ysp-021228/wheel-legged_robot/picture/1106d787874c910906931e404e03258.jpg

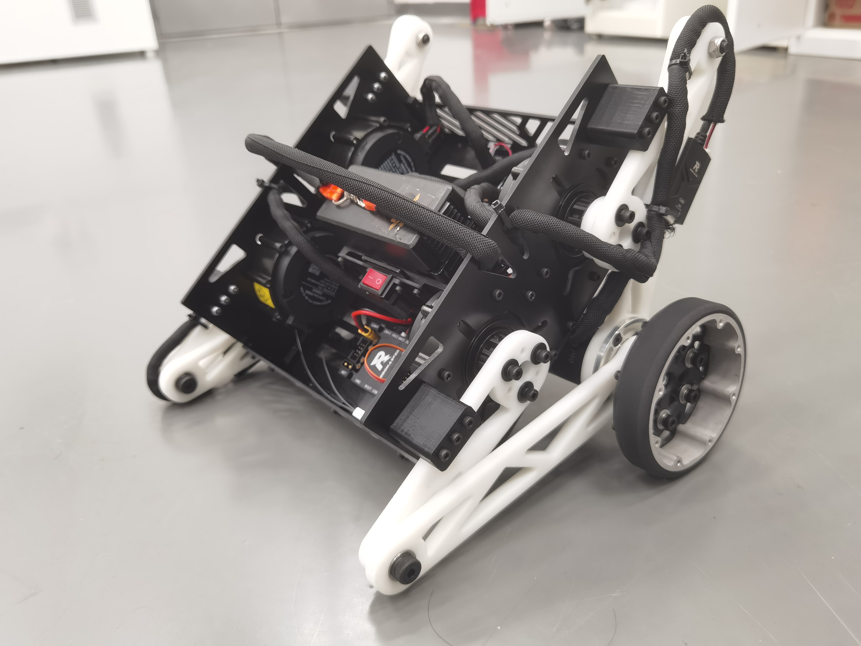
picture/1106d787874c910906931e404e03258.jpg
