ysp-021228/wheel-legged_robot/picture/f1f453ee73a97a37a0b2060098c7de4.jpg

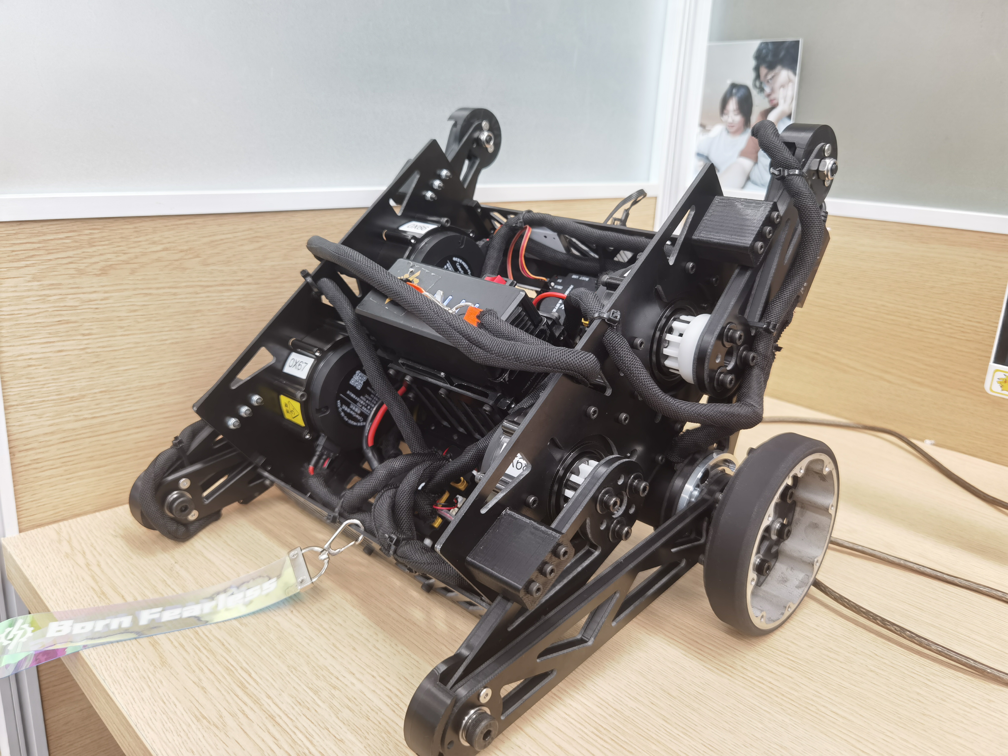
picture/f1f453ee73a97a37a0b2060098c7de4.jpg
