ysp-021228/wheel-legged_robot/picture/封面.png

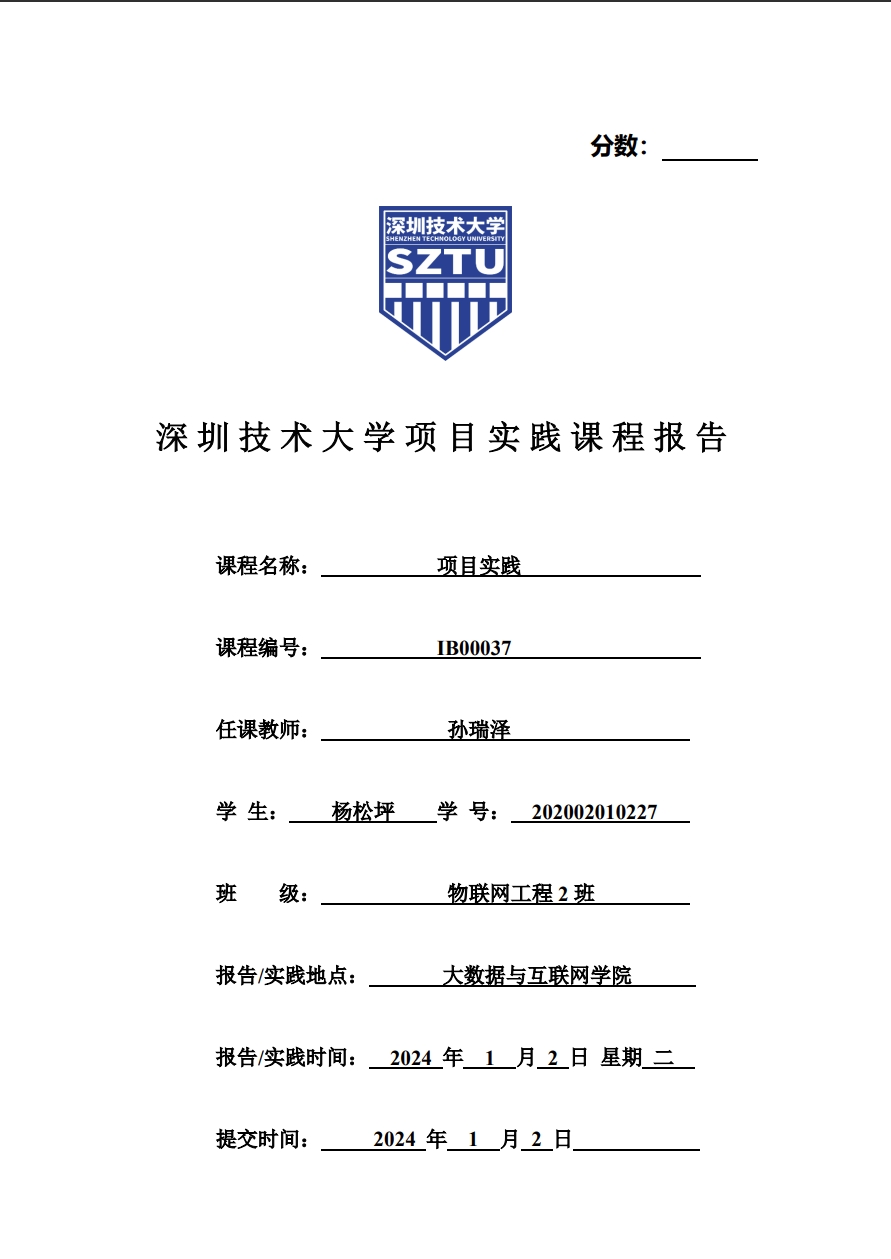
picture/封面.png
