ysp-021228/wheel-legged_robot/picture/支持力图片.jpg

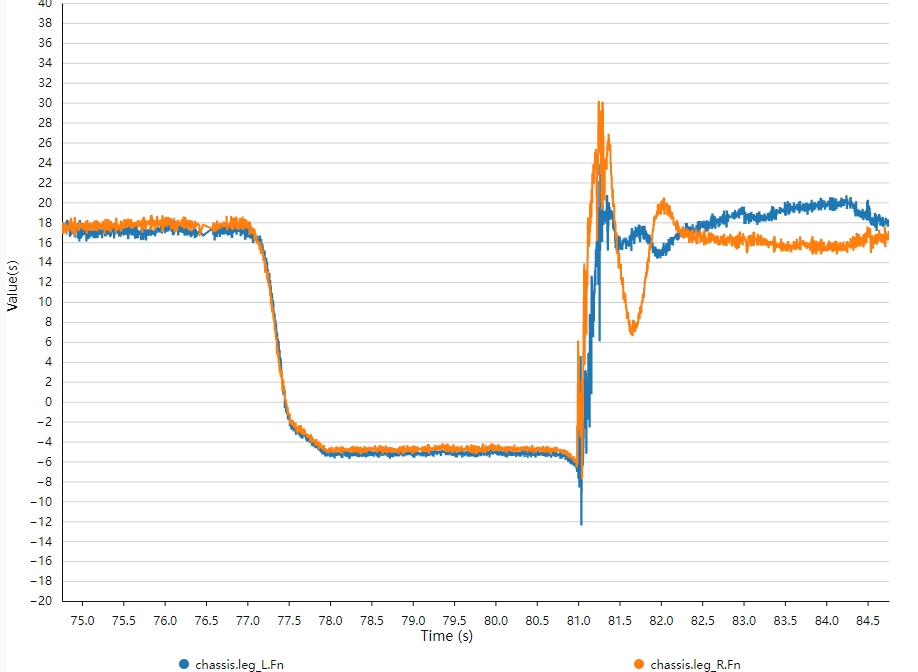
picture/支持力图片.jpg
