ysp-021228/wheel-legged_robot/picture/离地图片.jpg

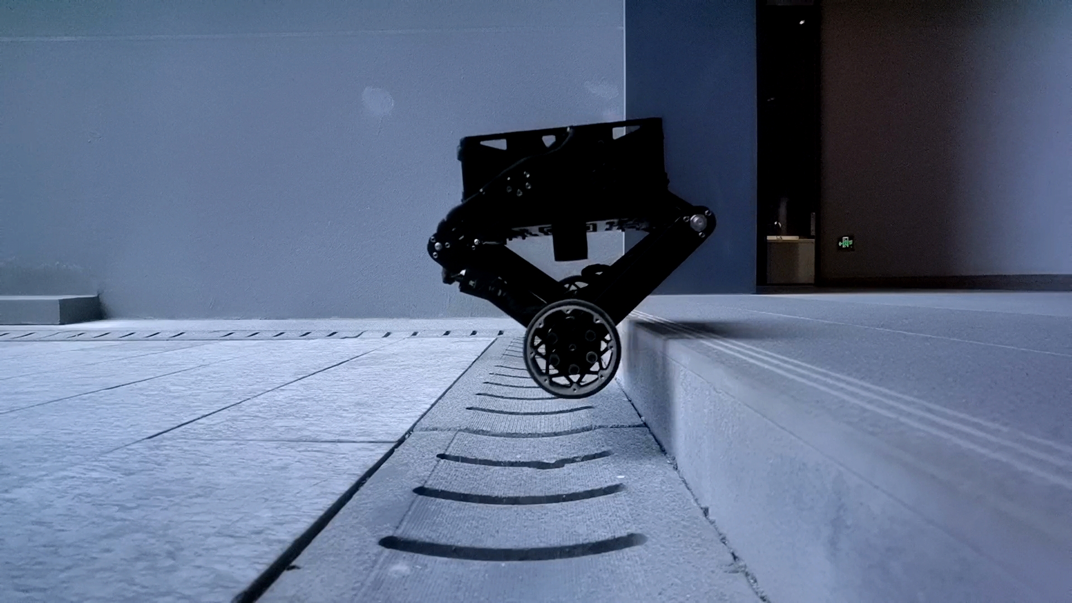
picture/离地图片.jpg
