ysp-021228/wheel-legged_robot/Core/Inc/main.h

#define BUTTON_TRIG_Pin GPIO_PIN_7
#define BUTTON_TRIG_GPIO_Port GPIOI
#define RSTN_IST8310_Pin GPIO_PIN_6
#define RSTN_IST8310_GPIO_Port GPIOG
#define LED_R_Pin GPIO_PIN_12
#define LED_R_GPIO_Port GPIOH
#define DRDY_IST8310_Pin GPIO_PIN_3
#define DRDY_IST8310_GPIO_Port GPIOG
#define DRDY_IST8310_EXTI_IRQn EXTI3_IRQn
#define ADC_BAT_Pin GPIO_PIN_10
#define ADC_BAT_GPIO_Port GPIOF
#define LED_G_Pin GPIO_PIN_11
#define LED_G_GPIO_Port GPIOH
#define LED_B_Pin GPIO_PIN_10
#define LED_B_GPIO_Port GPIOH
#define HW0_Pin GPIO_PIN_0
#define HW0_GPIO_Port GPIOC
#define HW1_Pin GPIO_PIN_1
#define HW1_GPIO_Port GPIOC
#define HW2_Pin GPIO_PIN_2
#define HW2_GPIO_Port GPIOC
#define BUZZER_Pin GPIO_PIN_14
#define BUZZER_GPIO_Port GPIOD
#define KEY_Pin GPIO_PIN_0
#define KEY_GPIO_Port GPIOA
#define CS1_ACCEL_Pin GPIO_PIN_4
#define CS1_ACCEL_GPIO_Port GPIOA
#define INT1_ACCEL_Pin GPIO_PIN_4
#define INT1_ACCEL_GPIO_Port GPIOC
#define INT1_ACCEL_EXTI_IRQn EXTI4_IRQn
#define INT1_GYRO_Pin GPIO_PIN_5
#define INT1_GYRO_GPIO_Port GPIOC
#define INT1_GYRO_EXTI_IRQn EXTI9_5_IRQn
#define SPI2_CS_Pin GPIO_PIN_12
#define SPI2_CS_GPIO_Port GPIOB
#define CS1_GYRO_Pin GPIO_PIN_0
#define CS1_GYRO_GPIO_Port GPIOB
