ysp-021228/wheel-legged_robot/App/Src/Bot/Device/CyberGear.c

#include "Device/CyberGear.h"
#include "can.h"

/*
 * 小米电机使用说明
 * 1.需要在CAN中断回调函数调用mi_motor_data_get()函数，以确保数据接收
 * 2.在使用前使用mi_motor_init()函数实现电机初始化 须填入CAN总线句柄和电机id及对应的结构体数组
 * 3.使用mi_motor_mode()函数设置电机模式 0:运控模式 1:位置模式 2:速度模式 3:电流模式（默认为运控模式）
 * 4.使用mi_motor_enable()函数使能电机
 * 5.使用mi_motor_disable()函数失能电机
 * 6.使用mi_motor_control_mode()函数设置电机运控模式（运控模式）
 * 7.使用mi_motor_write()函数设置电机参数（位置模式，速度模式，电流模式）
 * 8.使用mi_motor_read()函数读取电机设置参数
 */

/**
 * @brief 小米电机CAN1数据数组
 */
struct CyberGearData cybergears_1[MI_MOTOR_SINGLE_NUM];

/**
 * @brief 小米电机CAN2数据数组
 */
struct CyberGearData cybergears_2[MI_MOTOR_SINGLE_NUM];

/**
 * @brief 小米电机CAN 扩展帧ID信息联合体
 */
union {
  uint32_t ExtId;
  struct {
    uint32_t id: 8;
    uint32_t data: 16;
    uint32_t mode: 5;
    uint32_t res: 3;
  };
} exCanIdInfo;

static int float_to_uint(float x, float x_min, float x_max);

static float uint_to_float(int x_int, float x_min, float x_max);

static void mi_motor_can_send(struct CyberGearData *mi_motor_data);

/**
 * @brief 小米电机CAN数据转换函数
 * @param x
 * @param x_min
 * @param x_max
 * @return
 */
static int float_to_uint(float x, float x_min, float x_max) {
  float span = x_max - x_min;
  float offset = x_min;
  if (x > x_max) x = x_max;
  else if (x < x_min) x = x_min;
  return (int) ((x - offset) * ((float) ((1 << 16) - 1)) / span);
}

/**
 * @brief 小米电机CAN数据转换函数
 * @param x_int
 * @param x_min
 * @param x_max
 * @return
 */
static float uint_to_float(int x_int, float x_min, float x_max) {
  //converts unsigned int to float, given range
  float span = x_max - x_min;
  float offset = x_min;
  return ((float) x_int) * span / ((float) ((1 << 16) - 1)) + offset;
}

/**
 * @brief 小米电机CAN发送函数
 * @param mi_motor_data 电机数据结构体
 */
static void mi_motor_can_send(struct CyberGearData *mi_motor_data) {
  CAN_TxHeaderTypeDef tx_header;
  uint8_t tx_data[8];
  uint32_t send_mail_box;
//  send_mail_box=get_free_can_mailbox();

  exCanIdInfo.mode = mi_motor_data->mode;
  exCanIdInfo.id = mi_motor_data->id;
  exCanIdInfo.data = mi_motor_data->data;
  exCanIdInfo.res = 0;

  tx_header.ExtId = exCanIdInfo.ExtId;
  tx_header.IDE = CAN_ID_EXT;
  tx_header.RTR = CAN_RTR_DATA;
  tx_header.DLC = 8;

  memcpy(tx_data, mi_motor_data->tx_data, 8);

  HAL_CAN_AddTxMessage(&mi_motor_data->canHandleTypeDef, &tx_header, tx_data, &send_mail_box);
}

/**
 * @brief 小米电机ID读取函数
 * @param mi_motor_data 电机数据结构体
 */
void mi_motor_id_get(struct CyberGearData *mi_motor_data) {
  mi_motor_data->mode = 0;
  union {
    uint16_t ex_data;
    struct {
      uint16_t master_id: 8;
      uint16_t res: 8;
    };
  } ex_data;
  ex_data.master_id = MI_MOTOR_MASTER_ID;
  ex_data.res = 0;
  mi_motor_data->data = ex_data.ex_data;
  memset(&mi_motor_data->tx_data, 0, 8);
  mi_motor_can_send(mi_motor_data);
}

/**
 * @brief 电机运控模式函数
 * @param mi_motor_data 电机数据结构体
 * @param torque 力矩指令 -12~12N.m
 * @param MechPosition 电机磁编码器角度指令 -12.5~12.5rad
 * @param speed 电机速度指令 -30~30rad/s
 * @param kp 位置环kp
 * @param kd 速度环kd
 */
void cyber_gear_control_mode(struct CyberGearData *mi_motor_data, float torque, float MechPosition, float speed, float kp,
                             float kd) {
  mi_motor_data->mode = 1;
  mi_motor_data->data = float_to_uint(torque, MI_MOTOR_T_MIN, MI_MOTOR_T_MAX);

  mi_motor_data->tx_data[0] = float_to_uint(MechPosition, MI_MOTOR_P_MIN, MI_MOTOR_P_MAX) >> 8;
  mi_motor_data->tx_data[1] = float_to_uint(MechPosition, MI_MOTOR_P_MIN, MI_MOTOR_P_MAX);
  mi_motor_data->tx_data[2] = float_to_uint(speed, MI_MOTOR_V_MIN, MI_MOTOR_V_MAX) >> 8;
  mi_motor_data->tx_data[3] = float_to_uint(speed, MI_MOTOR_V_MIN, MI_MOTOR_V_MAX);
  mi_motor_data->tx_data[4] = float_to_uint(kp, MI_MOTOR_KP_MIN, MI_MOTOR_KP_MAX) >> 8;
  mi_motor_data->tx_data[5] = float_to_uint(kp, MI_MOTOR_KP_MIN, MI_MOTOR_KP_MAX);
  mi_motor_data->tx_data[6] = float_to_uint(kd, MI_MOTOR_KD_MIN, MI_MOTOR_KD_MAX) >> 8;
  mi_motor_data->tx_data[7] = float_to_uint(kd, MI_MOTOR_KD_MIN, MI_MOTOR_KD_MAX);
  mi_motor_can_send(mi_motor_data);
}

/**
 * @brief 小米电机初始化函数（在电机使用前必须调用）
 * @param canHandleTypeDef 电机CAN总线选择 hcan1/hcan2
 * @param id 电机id
 * @param mi_motor_data 电机数据结构体
 */
void cyber_gear_init(CAN_HandleTypeDef canHandleTypeDef, uint8_t id, struct CyberGearData *mi_motor_data) {
  union {
    uint16_t ex_data;
    struct {
      uint16_t master_id: 8;
      uint16_t res: 8;
    };
  } ex_data;
  ex_data.master_id = MI_MOTOR_MASTER_ID;
  ex_data.res = 0;
  mi_motor_data->data = ex_data.ex_data;
  mi_motor_data->id = id;
  mi_motor_data->canHandleTypeDef = canHandleTypeDef;
  memset(&mi_motor_data->tx_data, 0, 8);
}

/**
 * @brief 小米电机使能函数
 * @param mi_motor_data 电机数据结构体
 */
void cyber_gear_enable(struct CyberGearData *mi_motor_data) {
  mi_motor_data->mode = 3;
  union {
    uint16_t ex_data;
    struct {
      uint16_t master_id: 8;
      uint16_t res: 8;
    };
  } ex_data;
  ex_data.master_id = MI_MOTOR_MASTER_ID;
  ex_data.res = 0;
  mi_motor_data->data = ex_data.ex_data;
  memset(&mi_motor_data->tx_data, 0, 8);
  mi_motor_can_send(mi_motor_data);
}

/**
 * @brief 小米电机失能函数
 * @param mi_motor_data 电机数据结构体
 */
void mi_motor_disable(struct CyberGearData *mi_motor_data) {
  mi_motor_data->mode = 4;
  union {
    uint16_t ex_data;
    struct {
      uint16_t master_id: 8;
      uint16_t res: 8;
    };
  } ex_data;
  ex_data.master_id = MI_MOTOR_MASTER_ID;
  ex_data.res = 0;
  mi_motor_data->data = ex_data.ex_data;
  memset(&mi_motor_data->tx_data, 0, 8);
  mi_motor_can_send(mi_motor_data);
}

/**
 * @brief 小米电机清除错误函数
 * @param mi_motor_data 电机数据结构体
 */
void mi_motor_clear_err(struct CyberGearData *mi_motor_data) {
  mi_motor_data->mode = 4;
  union {
    uint16_t ex_data;
    struct {
      uint16_t master_id: 8;
      uint16_t res: 8;
    };
  } ex_data;
  ex_data.master_id = MI_MOTOR_MASTER_ID;
  ex_data.res = 0;
  mi_motor_data->data = ex_data.ex_data;
  memset(&mi_motor_data->tx_data, 0, 8);
  mi_motor_data->tx_data[0] = 1;
  mi_motor_can_send(mi_motor_data);
}

/**
 * @brief 小米电机设置零点函数
 * @param mi_motor_data 电机数据结构体
 */
void mi_motor_set_zero(struct CyberGearData *mi_motor_data) {
  mi_motor_data->mode = 6;
  union {
    uint16_t ex_data;
    struct {
      uint16_t master_id: 8;
      uint16_t res: 8;
    };
  } ex_data;
  ex_data.master_id = MI_MOTOR_MASTER_ID;
  ex_data.res = 0;
  mi_motor_data->data = ex_data.ex_data;
  memset(&mi_motor_data->tx_data, 0, 8);
  mi_motor_data->tx_data[0] = 1;
  mi_motor_can_send(mi_motor_data);
}

/**
 * @brief 小米电机设置id函数
 * @param mi_motor_data 电机数据结构体
 * @param set_id 设置新的id值
 */
void mi_motor_set_id(struct CyberGearData *mi_motor_data, uint8_t set_id) {
  mi_motor_data->mode = 7;
  union {
    uint16_t ex_data;
    struct {
      uint16_t master_id: 8;
      uint16_t set_id: 8;
    };
  } ex_data;
  ex_data.master_id = MI_MOTOR_MASTER_ID;
  ex_data.set_id = set_id;
  mi_motor_data->data = ex_data.ex_data;
  memset(&mi_motor_data->tx_data, 0, 8);
  mi_motor_can_send(mi_motor_data);
}

/**
 * @brief 小米电机数据读取函数
 * @param mi_motor_data 电机数据结构体
 * @param index 参数
 */
void mi_motor_read(struct CyberGearData *mi_motor_data, uint16_t index) {
  mi_motor_data->mode = 17;
  union {
    uint16_t ex_data;
    struct {
      uint16_t master_id: 8;
      uint16_t res: 8;
    };
  } ex_data;
  ex_data.master_id = MI_MOTOR_MASTER_ID;
  ex_data.res = 0;
  mi_motor_data->data = ex_data.ex_data;
  memset(&mi_motor_data->tx_data, 0, 8);
  memcpy(&mi_motor_data->tx_data[0], &index, 2);
  mi_motor_can_send(mi_motor_data);
}

/**
 * @brief 小米电机模式设置函数
 * @param mi_motor_data 电机数据结构体
 * @param mode 模式 0:运控模式 1:位置模式 2:速度模式 3:电流模式
 */
void cyber_gear_mode(struct CyberGearData *mi_motor_data, uint8_t mode) {
  uint16_t index = MI_MOTOR_RUN_MODE_INDEX;
  mi_motor_data->mode = 18;
  union {
    uint16_t ex_data;
    struct {
      uint16_t master_id: 8;
      uint16_t res: 8;
    };
  } ex_data;
  ex_data.master_id = MI_MOTOR_MASTER_ID;
  ex_data.res = 0;
  mi_motor_data->data = ex_data.ex_data;
  memset(&mi_motor_data->tx_data, 0, 8);
  memcpy(&mi_motor_data->tx_data[0], &index, 2);
  memcpy(&mi_motor_data->tx_data[4], &mode, 1);
  mi_motor_can_send(mi_motor_data);
}

/**
 * @brief 小米电机数据写入函数
 * @param mi_motor_data 电机数据结构体
 * @param index 参数
 * @param ref   参数值
 */
void mi_motor_write(struct CyberGearData *mi_motor_data, uint16_t index, float ref) {
  mi_motor_data->mode = 18;
  union {
    uint16_t ex_data;
    struct {
      uint16_t master_id: 8;
      uint16_t res: 8;
    };
  } ex_data;
  ex_data.master_id = MI_MOTOR_MASTER_ID;
  ex_data.res = 0;
  mi_motor_data->data = ex_data.ex_data;
  memset(&mi_motor_data->tx_data, 0, 8);
  memcpy(&mi_motor_data->tx_data[0], &index, 2);
  memcpy(&mi_motor_data->tx_data[4], &ref, 4);
  mi_motor_can_send(mi_motor_data);
}

/**
 * @brief 小米电机CAN数据读取函数（需要在CAN中断回调中调用）
 * @param hcan
 * @param rx_header
 * @param rx_data
 */
void mi_motor_data_get(CAN_HandleTypeDef *hcan, CAN_RxHeaderTypeDef rx_header, const uint8_t rx_data[8]) {
  exCanIdInfo.ExtId = rx_header.ExtId;
  union {
    uint16_t ex_data;
    struct {
      uint16_t motor_id: 8;
      uint16_t res: 8;
    };
  } ex_data;
  ex_data.ex_data = exCanIdInfo.data;
  if (hcan == &hcan1) {
    if (exCanIdInfo.mode == 2) {
      cybergears_1[ex_data.motor_id].id = ex_data.motor_id;
      cybergears_1[ex_data.motor_id].mode = exCanIdInfo.mode;
      cybergears_1[ex_data.motor_id].data = exCanIdInfo.data;

      uint16_t raw_angle = (int16_t) ((rx_data[0] << 8) | rx_data[1]);
      uint16_t raw_speed = (int16_t) ((rx_data[2] << 8) | rx_data[3]);
      uint16_t raw_torque = (int16_t) ((rx_data[4] << 8) | rx_data[5]);
      uint16_t raw_temp = (int16_t) ((rx_data[6] << 8) | rx_data[7]);

      cybergears_1[ex_data.motor_id].angle = uint_to_float(raw_angle, MI_MOTOR_P_MIN, MI_MOTOR_P_MAX);
      cybergears_1[ex_data.motor_id].speed = uint_to_float(raw_speed, MI_MOTOR_V_MIN, MI_MOTOR_V_MAX);
      cybergears_1[ex_data.motor_id].torque = uint_to_float(raw_torque, MI_MOTOR_T_MIN, MI_MOTOR_T_MAX);
      cybergears_1[ex_data.motor_id].temp = (float) raw_temp / 10.0f;

    } else if (exCanIdInfo.mode == 17) {
      memcpy(cybergears_1[ex_data.motor_id].index, rx_data, 2);
      memcpy(cybergears_1[ex_data.motor_id].ref, &rx_data[4], 4);
    } else if (exCanIdInfo.mode == 21) {
      memcpy(cybergears_1[ex_data.motor_id].fault, rx_data, 4);
      memcpy(cybergears_1[ex_data.motor_id].warning, &rx_data[4], 4);
    }
  } else if (hcan == &hcan2) {
    if (exCanIdInfo.mode == 2) {
      cybergears_2[ex_data.motor_id].id = ex_data.motor_id;
      cybergears_2[ex_data.motor_id].mode = exCanIdInfo.mode;
      cybergears_2[ex_data.motor_id].data = exCanIdInfo.data;

      uint16_t raw_angle = (int16_t) ((rx_data[0] << 8) | rx_data[1]);
      uint16_t raw_speed = (int16_t) ((rx_data[2] << 8) | rx_data[3]);
      uint16_t raw_torque = (int16_t) ((rx_data[4] << 8) | rx_data[5]);
      uint16_t raw_temp = (int16_t) ((rx_data[6] << 8) | rx_data[7]);

      cybergears_2[ex_data.motor_id].angle = uint_to_float(raw_angle, MI_MOTOR_P_MIN, MI_MOTOR_P_MAX);
      cybergears_2[ex_data.motor_id].speed = uint_to_float(raw_speed, MI_MOTOR_V_MIN, MI_MOTOR_V_MAX);
      cybergears_2[ex_data.motor_id].torque = uint_to_float(raw_torque, MI_MOTOR_T_MIN, MI_MOTOR_T_MAX);
      cybergears_2[ex_data.motor_id].temp = (float) raw_temp / 10.0f;

    } else if (exCanIdInfo.mode == 17) {
      memcpy(cybergears_2[ex_data.motor_id].index, rx_data, 2);
      memcpy(cybergears_2[ex_data.motor_id].ref, &rx_data[4], 4);
    } else if (exCanIdInfo.mode == 21) {
      memcpy(cybergears_2[ex_data.motor_id].fault, rx_data, 4);
      memcpy(cybergears_2[ex_data.motor_id].warning, &rx_data[4], 4);
    }
  }
}
