ysp-021228/wheel-legged_robot/App/Inc/Bot/Device/key_board.h

//
// Created by xhuanc on 2021/12/3.
//

#ifndef DEMO1_KEY_BOARD_H
#define DEMO1_KEY_BOARD_H
#include "IO/remote.h"

#define DEFAULT_CNT 100/24 // 100/任务周期=实际经过时间
#define MOUSE_CLICK_R_CNT 5
#define MOUSE_CLICK_L_CNT 20
#define MOUSE_X_RADIO 0.015f
#define MOUSE_Y_RADIO 0.01f

typedef enum{
    KEY_RELAX,//按键没被按下
    KEY_DOWN,
    KEY_CLICK,//PRESS 一下之后就RELAX 就是CLICK
    KEY_PRESS,//PRESS 超过一段时间 DOWN
}Key_Status;

typedef struct {
    Key_Status status;
    Key_Status last_status;
    uint32_t press_cnt;
    uint8_t click_flag;
    uint32_t click_cnt;
}Key;

//键盘结构体
typedef struct {
    Key Mouse_l;
    Key Mouse_r;
    Key W;
    Key S;
    Key A;
    Key D;
    Key Q;
    Key E;
    Key R;
    Key F;
    Key G;
    Key Z;
    Key X;
    Key C;
    Key B;
    Key V;
    Key SHIFT;
    Key CTRL;
}key_board_t;
extern void update_pc_info();

#endif //DEMO1_KEY_BOARD_H
