ysp-021228/wheel-legged_robot/bsp/bsp_usart.h

#ifndef BSP_USART_H
#define BSP_USART_H
#include "struct_typedef.h"

extern void usart1_init(uint8_t *rx_buf,uint16_t dma_buf_num);
extern void usart6_init(uint8_t *rx1_buf,uint16_t dma_buf_num);
extern void uart6_tx_one_byte(uint8_t* data);
extern void uart6_tx_mul_byte_dma(uint8_t* data,uint16_t len);
extern void usart6_tx_dma_enable(uint8_t* data,uint16_t len);
extern void usart1_tx_dma_init(void);
extern void usart1_tx_dma_enable(uint8_t *data, uint16_t len);
#endif
