ysp-021228/wheel-legged_robot/App/Src/Bot/Device/Calibrate.c

/**
  ****************************(C) COPYRIGHT 2019 DJI****************************
  * @file       calibrate_task.c/h
  * @brief      calibrate these device，include gimbal, gyro, accel, magnetometer,
  *             chassis. gimbal calibration is to calc the midpoint, max/min
  *             relative angle. gyro calibration is to calc the zero drift.
  *             accel and mag calibration have not been implemented yet, because
  *             accel is not necessary to calibrate, mag is not used. chassis
  *             calibration is to make motor 3508 enter quick reset ID mode.
  *             校准设备，包括云台,陀螺仪,加速度计,磁力计,底盘.云台校准是主要计算零点
  *             和最大最小相对角度.云台校准是主要计算零漂.加速度计和磁力计校准还没有实现
  *             因为加速度计还没有必要去校准,而磁力计还没有用.底盘校准是使M3508进入快速
  *             设置ID模式.
  * @note
  * @history
  *  Version    Date            Author          Modification
  *  V1.0.0     Oct-25-2018     RM              1. done
  *  V1.1.0     Nov-11-2019     RM              1. add chassis clabration
  *
  @verbatim
  ==============================================================================
  *             use the remote control begin calibrate,
  *             first: two switchs of remote control are down
  *             second:hold for 2 seconds, two rockers set to V, like \../;  \. means the letf rocker go bottom right.
  *             third:hold for 2 seconds, two rockers set to ./\., begin the gyro calibration
  *                     or set to '\/', begin the gimbal calibration
  *                     or set to /''\, begin the chassis calibration
  *
  *             data in flash, include cali data and name[3] and cali_flag
  *             for example, head_cali has 8 bytes, and it need 12 bytes in flash. if it starts in 0x080A0000
  *             0x080A0000-0x080A0007: head_cali data
  *             0x080A0008: name[0]
  *             0x080A0009: name[1]
  *             0x080A000A: name[2]
  *             0x080A000B: cali_flag, when cali_flag == 0x55, means head_cali has been calibrated.
  *             if add a sensor
  *             1.add cail sensro name in cali_id_e at calibrate_task.h, like
  *             typedef enum
  *             {
  *                 ...
  *                 //add more...
  *                 CALI_XXX,
  *                 CALI_LIST_LENGHT,
  *             } cali_id_e;
  *             2. add the new data struct in calibrate_task.h, must be 4 four-byte mulitple  like
  *
  *             typedef struct
  *             {
  *                 uint16_t xxx;
  *                 uint16_t yyy;
  *                 fp32 zzz;
  *             } xxx_cali_t; //size: 8 bytes, must be 4, 8, 12, 16...
  *             3.in "FLASH_WRITE_BUF_LENGHT", add "sizeof(xxx_cali_t)", and implement new function.
  *             bool_t cali_xxx_hook(uint32_t *cali, bool_t cmd), and add the name in "cali_name[CALI_LIST_LENGHT][3]"
  *             and declare variable xxx_cali_t xxx_cail, add the data address in cali_sensor_buf[CALI_LIST_LENGHT]
  *             and add the data lenght in cali_sensor_size, at last, add function in cali_hook_fun[CALI_LIST_LENGHT]
  *             使用遥控器进行开始校准
  *             第一步:遥控器的两个开关都打到下
  *             第二步:两个摇杆打成\../,保存两秒.\.代表左摇杆向右下打.
  *             第三步:摇杆打成./\. 开始陀螺仪校准
  *                    或者摇杆打成'\/' 开始云台校准021228
  *                    或者摇杆打成/''\ 开始底盘校准
  *
  *             数据在flash中，包括校准数据和名字 name[3] 和 校准标志位 cali_flag
  *             例如head_cali有八个字节,但它需要12字节在flash,如果它从0x080A0000开始
  *             0x080A0000-0x080A0007: head_cali数据
  *             0x080A0008: 名字name[0]
  *             0x080A0009: 名字name[1]
  *             0x080A000A: 名字name[2]
  *             0x080A000B: 校准标志位 cali_flag,当校准标志位为0x55,意味着head_cali已经校准了
  *             添加新设备
  *             1.添加设备名在calibrate_task.h的cali_id_e, 像
  *             typedef enum
  *             {
  *                 ...
  *                 //add more...
  *                 CALI_XXX,
  *                 CALI_LIST_LENGHT,
  *             } cali_id_e;
  *             2. 添加数据结构在 calibrate_task.h, 必须4字节倍数，像
  *
  *             typedef struct
  *             {
  *                 uint16_t xxx;
  *                 uint16_t yyy;
  *                 fp32 zzz;
  *             } xxx_cali_t; //长度:8字节 8 bytes, 必须是 4, 8, 12, 16...
  *             3.在 "FLASH_WRITE_BUF_LENGHT",添加"sizeof(xxx_cali_t)", 和实现新函数
  *             bool_t cali_xxx_hook(uint32_t *cali, bool_t cmd), 添加新名字在 "cali_name[CALI_LIST_LENGHT][3]"
  *             和申明变量 xxx_cali_t xxx_cail, 添加变量地址在cali_sensor_buf[CALI_LIST_LENGHT]
  *             在cali_sensor_size[CALI_LIST_LENGHT]添加数据长度, 最后在cali_hook_fun[CALI_LIST_LENGHT]添加函数
  *
  ==============================================================================
  @endverbatim
  ****************************(C) COPYRIGHT 2019 DJI****************************
  */

#include "Device/Calibrate.h"
#include "string.h"
#include "cmsis_os.h"

#include "bsp_adc.h"
#include "bsp_buzzer.h"
#include "bsp_flash.h"

#include "IO/can_receive.h"
#include "IO/remote.h"
#include "Atti.h"
#include "Subsystem/Gimbal.h"


//include head,gimbal,gyro,accel,mag. gyro,accel and mag have the same data struct. total 5(CALI_LIST_LENGHT) devices, need data lenght + 5 * 4 bytes(name[3]+cali)
#define FLASH_WRITE_BUF_LENGHT  (sizeof(head_cali_t) + sizeof(gimbal_cali_t) + sizeof(imu_cali_t) * 3  + CALI_LIST_LENGHT * 4)




/**
  * @brief          use remote control to begin a calibrate,such as gyro, gimbal, chassis
  * @param[in]      none
  * @retval         none
  */
/**
  * @brief          使用遥控器开始校准，例如陀螺仪，云台，底盘
  * @param[in]      none
  * @retval         none
  */
static void RC_cmd_to_calibrate(void);

/**
  * @brief          read cali data from flash
  * @param[in]      none
  * @retval         none
  */
/**
  * @brief          从flash读取校准数据
  * @param[in]      none
  * @retval         none
  */
static void cali_data_read(void);

/**
  * @brief          write the data to flash
  * @param[in]      none
  * @retval         none
  */
/**
  * @brief          往flash写入校准数据
  * @param[in]      none
  * @retval         none
  */
static void cali_data_write(void);


/**
  * @brief          "head" sensor cali function
  * @param[in][out] cali:the point to head data. when cmd == CALI_FUNC_CMD_INIT, param is [in],cmd == CALI_FUNC_CMD_ON, param is [out]
  * @param[in]      cmd:
                    CALI_FUNC_CMD_INIT: means to use cali data to initialize original data
                    CALI_FUNC_CMD_ON: means need to calibrate
  * @retval         0:means cali task has not been done
                    1:means cali task has been done
  */
/**
  * @brief          "head"设备校准
  * @param[in][out] cali:指针指向head数据,当cmd为CALI_FUNC_CMD_INIT, 参数是输入,CALI_FUNC_CMD_ON,参数是输出
  * @param[in]      cmd:
                    CALI_FUNC_CMD_INIT: 代表用校准数据初始化原始数据
                    CALI_FUNC_CMD_ON: 代表需要校准
  * @retval         0:校准任务还没有完
                    1:校准任务已经完成
  */
static bool_t cali_head_hook(uint32_t *cali, bool_t cmd);   //header device cali function

/**
  * @brief          gyro cali function
  * @param[in][out] cali:the point to gyro data, when cmd == CALI_FUNC_CMD_INIT, param is [in],cmd == CALI_FUNC_CMD_ON, param is [out]
  * @param[in]      cmd:
                    CALI_FUNC_CMD_INIT: means to use cali data to initialize original data
                    CALI_FUNC_CMD_ON: means need to calibrate
  * @retval         0:means cali task has not been done
                    1:means cali task has been done
  */
/**
  * @brief          陀螺仪设备校准
  * @param[in][out] cali:指针指向陀螺仪数据,当cmd为CALI_FUNC_CMD_INIT, 参数是输入,CALI_FUNC_CMD_ON,参数是输出
  * @param[in]      cmd:
                    CALI_FUNC_CMD_INIT: 代表用校准数据初始化原始数据
                    CALI_FUNC_CMD_ON: 代表需要校准
  * @retval         0:校准任务还没有完
                    1:校准任务已经完成
  */
static bool_t cali_gyro_hook(uint32_t *cali, bool_t cmd);   //gyro device cali function

/**
  * @brief          gimbal cali function
  * @param[in][out] cali:the point to gimbal data, when cmd == CALI_FUNC_CMD_INIT, param is [in],cmd == CALI_FUNC_CMD_ON, param is [out]
  * @param[in]      cmd:
                    CALI_FUNC_CMD_INIT: means to use cali data to initialize original data
                    CALI_FUNC_CMD_ON: means need to calibrate
  * @retval         0:means cali task has not been done
                    1:means cali task has been done
  */
/**
  * @brief          云台设备校准
  * @param[in][out] cali:指针指向云台数据,当cmd为CALI_FUNC_CMD_INIT, 参数是输入,CALI_FUNC_CMD_ON,参数是输出
  * @param[in]      cmd:
                    CALI_FUNC_CMD_INIT: 代表用校准数据初始化原始数据
                    CALI_FUNC_CMD_ON: 代表需要校准
  * @retval         0:校准任务还没有完
                    1:校准任务已经完成
  */
static bool_t cali_gimbal_hook(uint32_t *cali, bool_t cmd); //gimbal device cali function



#if INCLUDE_uxTaskGetStackHighWaterMark
uint32_t calibrate_task_stack;
#endif

extern struct RCCtrl rc_ctrl;
static const struct RCCtrl *calibrate_RC;   //remote control point
head_cali_t     head_cali;       //head cali data
gimbal_cali_t   gimbal_cali;     //gimbal cali data
imu_cali_t      accel_cali;      //accel cali data
imu_cali_t      gyro_cali;       //gyro cali data
imu_cali_t      mag_cali;        //mag cali data


static uint8_t flash_write_buf[FLASH_WRITE_BUF_LENGHT];

cali_sensor_t cali_sensor[CALI_LIST_LENGHT];

static const uint8_t cali_name[CALI_LIST_LENGHT][3] = {"HD", "GM", "GYR", "ACC", "MAG"};

//cali data address
static uint32_t *cali_sensor_buf[CALI_LIST_LENGHT] = {
        (uint32_t *)&head_cali, (uint32_t *)&gimbal_cali,
        (uint32_t *)&gyro_cali, (uint32_t *)&accel_cali,
        (uint32_t *)&mag_cali
};


static uint8_t cali_sensor_size[CALI_LIST_LENGHT] =
        {
                sizeof(head_cali_t) / 4, sizeof(gimbal_cali_t) / 4,
                sizeof(imu_cali_t) / 4, sizeof(imu_cali_t) / 4, sizeof(imu_cali_t) / 4};

void *cali_hook_fun[CALI_LIST_LENGHT] = {cali_head_hook, cali_gimbal_hook, cali_gyro_hook, NULL, NULL};

static uint32_t calibrate_systemTick;


/**
  * @brief          calibrate task, created by main function
  * @param[in]      pvParameters: null
  * @retval         none
  */
/**
  * @brief          校准任务，由main函数创建
  * @param[in]      pvParameters: 空
  * @retval         none
  */
void calibrate_task(void const *pvParameters)
{
    static uint8_t i = 0;

    calibrate_RC = &rc_ctrl;

    while (1)
    {

        RC_cmd_to_calibrate();

        for (i = 0; i < CALI_LIST_LENGHT; i++)
        {
            if (cali_sensor[i].cali_cmd)
            {
                if (cali_sensor[i].cali_hook != NULL)
                {

                    if (cali_sensor[i].cali_hook(cali_sensor_buf[i], CALI_FUNC_CMD_ON))
                    {
                        //done
                        cali_sensor[i].name[0] = cali_name[i][0];
                        cali_sensor[i].name[1] = cali_name[i][1];
                        cali_sensor[i].name[2] = cali_name[i][2];
                        //set 0x55
                        cali_sensor[i].cali_done = CALIED_FLAG;

                        cali_sensor[i].cali_cmd = 0;
                        //write
                        cali_data_write();
                    }
                }
            }
        }
        osDelay(CALIBRATE_CONTROL_TIME);
#if INCLUDE_uxTaskGetStackHighWaterMark
        calibrate_task_stack = uxTaskGetStackHighWaterMark(NULL);
#endif
    }
}

/**
  * @brief          get imu control temperature, unit ℃
  * @param[in]      none
  * @retval         imu control temperature
  */
/**
  * @brief          获取imu控制温度, 单位℃
  * @param[in]      none
  * @retval         imu控制温度
  */
int8_t get_control_temperature(void)
{

    return head_cali.temperature;
}

/**
  * @brief          get latitude, default 22.0f
  * @param[out]     latitude: the point to fp32
  * @retval         none
  */
/**
  * @brief          获取纬度,默认22.0f
  * @param[out]     latitude:fp32指针
  * @retval         none
  */
void get_flash_latitude(float *latitude)
{

    if (latitude == NULL)
    {

        return;
    }
    if (cali_sensor[CALI_HEAD].cali_done == CALIED_FLAG)
    {
        *latitude = head_cali.latitude;
    }
    else
    {
        *latitude = 22.0f;
    }
}

/**
  * @brief          use remote control to begin a calibrate,such as gyro, gimbal, chassis
  * @param[in]      none
  * @retval         none
  */
/**
  * @brief          使用遥控器开始校准，例如陀螺仪，云台，底盘
  * @param[in]      none
  * @retval         none
  */
 uint16_t buzzer_time       = 0;
 uint16_t rc_cmd_time       = 0;
 uint8_t  rc_action_flag    = 0;
static void RC_cmd_to_calibrate(void)
{
    static const uint8_t BEGIN_FLAG   = 1;
    static const uint8_t GIMBAL_FLAG  = 2;
    static const uint8_t GYRO_FLAG    = 3;
    static const uint8_t CHASSIS_FLAG = 4;

    static uint8_t  i;
    static uint32_t rc_cmd_systemTick = 0;


    //if something is calibrating, return
    //如果已经在校准，就返回
    for (i = 0; i < CALI_LIST_LENGHT; i++)
    {
        if (cali_sensor[i].cali_cmd)
        {
            buzzer_time = 0;
            rc_cmd_time = 0;
            rc_action_flag = 0;
            return;
        }
    }

    if (rc_action_flag == 0 && rc_cmd_time > RC_CMD_LONG_TIME)
    {
        rc_cmd_systemTick = xTaskGetTickCount();
        rc_action_flag = BEGIN_FLAG;
        rc_cmd_time = 0;
    }
    else if (rc_action_flag == GIMBAL_FLAG && rc_cmd_time > RC_CMD_LONG_TIME)
    {
        //gimbal cali,
        rc_action_flag = 0;
        rc_cmd_time = 0;
        cali_sensor[CALI_GIMBAL].cali_cmd = 1;
        cali_buzzer_off();
    }
    else if (rc_action_flag == 3 && rc_cmd_time > RC_CMD_LONG_TIME)
    {
        //gyro cali
        rc_action_flag = 0;
        rc_cmd_time = 0;
        cali_sensor[CALI_GYRO].cali_cmd = 1;
        //update control temperature
        head_cali.temperature = (int8_t)(cali_get_mcu_temperature()) + 10;
        if (head_cali.temperature > (int8_t)(GYRO_CONST_MAX_TEMP))
        {
            head_cali.temperature = (int8_t)(GYRO_CONST_MAX_TEMP);
        }
        cali_buzzer_off();
    }
    else if (rc_action_flag == CHASSIS_FLAG && rc_cmd_time > RC_CMD_LONG_TIME)
    {
        rc_action_flag = 0;
        rc_cmd_time = 0;
        //send CAN reset ID cmd to M3508
        //发送CAN重设ID命令到3508
//        CAN_cmd_chassis_reset_ID();
//        CAN_cmd_chassis_reset_ID();
//        CAN_cmd_chassis_reset_ID();
        cali_buzzer_off();
    }

    if (calibrate_RC->rc.ch[0] < -RC_CALI_VALUE_HOLE && calibrate_RC->rc.ch[1] < -RC_CALI_VALUE_HOLE && calibrate_RC->rc.ch[2] > RC_CALI_VALUE_HOLE && calibrate_RC->rc.ch[3] < -RC_CALI_VALUE_HOLE && switch_is_down(calibrate_RC->rc.s[0]) && switch_is_down(calibrate_RC->rc.s[1]) && rc_action_flag == 0)
    {
        //two rockers set to  \../, hold for 2 seconds,
        //两个摇杆打成 \../,保持2s
        rc_cmd_time++;
    }
    else if (calibrate_RC->rc.ch[0] > RC_CALI_VALUE_HOLE && calibrate_RC->rc.ch[1] > RC_CALI_VALUE_HOLE && calibrate_RC->rc.ch[2] < -RC_CALI_VALUE_HOLE && calibrate_RC->rc.ch[3] > RC_CALI_VALUE_HOLE && switch_is_down(calibrate_RC->rc.s[0]) && switch_is_down(calibrate_RC->rc.s[1]) && rc_action_flag != 0)
    {
        //two rockers set '\/', hold for 2 seconds
        //两个摇杆打成'\/',保持2s
        rc_cmd_time++;
        rc_action_flag = GIMBAL_FLAG;
    }
    else if (calibrate_RC->rc.ch[0] > RC_CALI_VALUE_HOLE && calibrate_RC->rc.ch[1] < -RC_CALI_VALUE_HOLE && calibrate_RC->rc.ch[2] < -RC_CALI_VALUE_HOLE && calibrate_RC->rc.ch[3] < -RC_CALI_VALUE_HOLE && switch_is_down(calibrate_RC->rc.s[0]) && switch_is_down(calibrate_RC->rc.s[1]) && rc_action_flag != 0)
    {
        //two rocker set to ./\., hold for 2 seconds
        //两个摇杆打成./\.,保持2s
        rc_cmd_time++;
        rc_action_flag = GYRO_FLAG;
    }
    else if (calibrate_RC->rc.ch[0] < -RC_CALI_VALUE_HOLE && calibrate_RC->rc.ch[1] > RC_CALI_VALUE_HOLE && calibrate_RC->rc.ch[2] > RC_CALI_VALUE_HOLE && calibrate_RC->rc.ch[3] > RC_CALI_VALUE_HOLE && switch_is_down(calibrate_RC->rc.s[0]) && switch_is_down(calibrate_RC->rc.s[1]) && rc_action_flag != 0)
    {
        //two rocker set to /''\, hold for 2 seconds
        //两个摇杆打成/''\,保持2s
        rc_cmd_time++;
        rc_action_flag = CHASSIS_FLAG;
    }
    else
    {
        rc_cmd_time = 0;
    }

    calibrate_systemTick = xTaskGetTickCount();

    if (calibrate_systemTick - rc_cmd_systemTick > CALIBRATE_END_TIME)
    {
        //over 20 seconds, end
        //超过20s,停止
        rc_action_flag = 0;
        return;
    }
    else if (calibrate_systemTick - rc_cmd_systemTick > RC_CALI_BUZZER_MIDDLE_TIME && rc_cmd_systemTick != 0 && rc_action_flag != 0)
    {
        rc_cali_buzzer_middle_on();
    }
    else if (calibrate_systemTick - rc_cmd_systemTick > 0 && rc_cmd_systemTick != 0 && rc_action_flag != 0)
    {
        rc_cali_buzzer_start_on();
    }

    if (rc_action_flag != 0)
    {
        buzzer_time++;
    }

    if (buzzer_time > RCCALI_BUZZER_CYCLE_TIME && rc_action_flag != 0)
    {
        buzzer_time = 0;
    }
    if (buzzer_time > RC_CALI_BUZZER_PAUSE_TIME && rc_action_flag != 0)
    {
        cali_buzzer_off();
    }
}

/**
  * @brief          use remote control to begin a calibrate,such as gyro, gimbal, chassis
  * @param[in]      none
  * @retval         none
  */
/**
  * @brief          使用遥控器开始校准，例如陀螺仪，云台，底盘
  * @param[in]      none
  * @retval         none
  */
void cali_param_init(void)
{
    uint8_t i = 0;

    for (i = 0; i < CALI_LIST_LENGHT; i++)
    {
        cali_sensor[i].flash_len = cali_sensor_size[i];
        cali_sensor[i].flash_buf = cali_sensor_buf[i];
        cali_sensor[i].cali_hook = (bool_t(*)(uint32_t *, bool_t))cali_hook_fun[i];
    }

    cali_data_read();

    for (i = 0; i < CALI_LIST_LENGHT; i++)
    {
        if (cali_sensor[i].cali_done == CALIED_FLAG)
        {
            if (cali_sensor[i].cali_hook != NULL)
            {
                //if has been calibrated, set to init
                cali_sensor[i].cali_hook(cali_sensor_buf[i], CALI_FUNC_CMD_INIT);
            }
        }
    }
}

/**
  * @brief          read cali data from flash
  * @param[in]      none
  * @retval         none
  */
/**
  * @brief          从flash读取校准数据
  * @param[in]      none
  * @retval         none
  */
static void cali_data_read(void)
{
    uint8_t flash_read_buf[CALI_SENSOR_HEAD_LEGHT * 4];
    uint8_t i = 0;
    uint16_t offset = 0;
    for (i = 0; i < CALI_LIST_LENGHT; i++)
    {

        //read the data in flash,
        cali_flash_read(FLASH_USER_ADDR + offset, cali_sensor[i].flash_buf, cali_sensor[i].flash_len);

        offset += cali_sensor[i].flash_len * 4;

        //read the name and cali leg_flag,
        cali_flash_read(FLASH_USER_ADDR + offset, (uint32_t *)flash_read_buf, CALI_SENSOR_HEAD_LEGHT);

        cali_sensor[i].name[0] = flash_read_buf[0];
        cali_sensor[i].name[1] = flash_read_buf[1];
        cali_sensor[i].name[2] = flash_read_buf[2];
        cali_sensor[i].cali_done = flash_read_buf[3];

        offset += CALI_SENSOR_HEAD_LEGHT * 4;

        if (cali_sensor[i].cali_done != CALIED_FLAG && cali_sensor[i].cali_hook != NULL)
        {
            cali_sensor[i].cali_cmd = 1;
        }
    }
}


/**
  * @brief          write the data to flash
  * @param[in]      none
  * @retval         none
  */
/**
  * @brief          往flash写入校准数据
  * @param[in]      none
  * @retval         none
  */
static void cali_data_write(void)
{
    uint8_t i = 0;
    uint16_t offset = 0;


    for (i = 0; i < CALI_LIST_LENGHT; i++)
    {
        //copy the data of device calibration data
        memcpy((void *)(flash_write_buf + offset), (void *)cali_sensor[i].flash_buf, cali_sensor[i].flash_len * 4);
        offset += cali_sensor[i].flash_len * 4;

        //copy the name and "CALI_FLAG" of device
        memcpy((void *)(flash_write_buf + offset), (void *)cali_sensor[i].name, CALI_SENSOR_HEAD_LEGHT * 4);
        offset += CALI_SENSOR_HEAD_LEGHT * 4;
    }

    //erase the page
    cali_flash_erase(FLASH_USER_ADDR,1);
    //write data
    cali_flash_write(FLASH_USER_ADDR, (uint32_t *)flash_write_buf, (FLASH_WRITE_BUF_LENGHT + 3) / 4);
}


/**
  * @brief          "head" sensor cali function
  * @param[in][out] cali:the point to head data. when cmd == CALI_FUNC_CMD_INIT, param is [in],cmd == CALI_FUNC_CMD_ON, param is [out]
  * @param[in]      cmd:
                    CALI_FUNC_CMD_INIT: means to use cali data to initialize original data
                    CALI_FUNC_CMD_ON: means need to calibrate
  * @retval         0:means cali task has not been done
                    1:means cali task has been done
  */
/**
  * @brief          "head"设备校准
  * @param[in][out] cali:指针指向head数据,当cmd为CALI_FUNC_CMD_INIT, 参数是输入,CALI_FUNC_CMD_ON,参数是输出
  * @param[in]      cmd:
                    CALI_FUNC_CMD_INIT: 代表用校准数据初始化原始数据
                    CALI_FUNC_CMD_ON: 代表需要校准
  * @retval         0:校准任务还没有完
                    1:校准任务已经完成
  */
static bool_t cali_head_hook(uint32_t *cali, bool_t cmd)
{
    head_cali_t *local_cali_t = (head_cali_t *)cali;
    if (cmd == CALI_FUNC_CMD_INIT)
    {
//        memcpy(&head_cali, local_cali_t, sizeof(head_cali_t));

        return 1;
    }
    // self id
    local_cali_t->self_id = SELF_ID;
    //imu control temperature
    local_cali_t->temperature = (int8_t)(cali_get_mcu_temperature()) + 10;
    //head_cali.temperature = (int8_t)(cali_get_mcu_temperature()) + 10;
    if (local_cali_t->temperature > (int8_t)(GYRO_CONST_MAX_TEMP))
    {
        local_cali_t->temperature = (int8_t)(GYRO_CONST_MAX_TEMP);
    }

    local_cali_t->firmware_version = FIRMWARE_VERSION;
    //shenzhen latitude
    local_cali_t->latitude = 22.0f;

    return 1;
}

/**
  * @brief          gyro cali function
  * @param[in][out] cali:the point to gyro data, when cmd == CALI_FUNC_CMD_INIT, param is [in],cmd == CALI_FUNC_CMD_ON, param is [out]
  * @param[in]      cmd:
                    CALI_FUNC_CMD_INIT: means to use cali data to initialize original data
                    CALI_FUNC_CMD_ON: means need to calibrate
  * @retval         0:means cali task has not been done
                    1:means cali task has been done
  */
/**
  * @brief          陀螺仪设备校准
  * @param[in][out] cali:指针指向陀螺仪数据,当cmd为CALI_FUNC_CMD_INIT, 参数是输入,CALI_FUNC_CMD_ON,参数是输出
  * @param[in]      cmd:
                    CALI_FUNC_CMD_INIT: 代表用校准数据初始化原始数据
                    CALI_FUNC_CMD_ON: 代表需要校准
  * @retval         0:校准任务还没有完
                    1:校准任务已经完成
  */
static bool_t cali_gyro_hook(uint32_t *cali, bool_t cmd)
{
    imu_cali_t *local_cali_t = (imu_cali_t *)cali;
    if (cmd == CALI_FUNC_CMD_INIT)
    {
        gyro_set_cali(local_cali_t->scale, local_cali_t->offset);

        return 0;
    }
    else if (cmd == CALI_FUNC_CMD_ON)
    {
        static uint16_t count_time = 0;
        gyro_cali_fun(local_cali_t->scale, local_cali_t->offset, &count_time);
        if (count_time > GYRO_CALIBRATE_TIME)
        {
            count_time = 0;
            cali_buzzer_off();
            gyro_cali_enable_control();
            return 1;
        }
        else
        {
            gyro_cali_disable_control(); //disable the remote control to make robot no move
            imu_start_buzzer();

            return 0;
        }
    }

    return 0;
}

/**
  * @brief          gimbal cali function
  * @param[in][out] cali:the point to gimbal data, when cmd == CALI_FUNC_CMD_INIT, param is [in],cmd == CALI_FUNC_CMD_ON, param is [out]
  * @param[in]      cmd:
                    CALI_FUNC_CMD_INIT: means to use cali data to initialize original data
                    CALI_FUNC_CMD_ON: means need to calibrate
  * @retval         0:means cali task has not been done
                    1:means cali task has been done
  */
/**
  * @brief          云台设备校准
  * @param[in][out] cali:指针指向云台数据,当cmd为CALI_FUNC_CMD_INIT, 参数是输入,CALI_FUNC_CMD_ON,参数是输出
  * @param[in]      cmd:
                    CALI_FUNC_CMD_INIT: 代表用校准数据初始化原始数据
                    CALI_FUNC_CMD_ON: 代表需要校准
  * @retval         0:校准任务还没有完
                    1:校准任务已经完成
  */
static bool_t cali_gimbal_hook(uint32_t *cali, bool_t cmd)
{

    gimbal_cali_t *local_cali_t = (gimbal_cali_t *)cali;
    if (cmd == CALI_FUNC_CMD_INIT)
    {
//        set_cali_gimbal_hook(local_cali_t->yaw_offset, local_cali_t->pitch_offset,
//                             local_cali_t->yaw_max_angle, local_cali_t->yaw_min_angle,
//                             local_cali_t->pitch_max_angle, local_cali_t->pitch_min_angle);

        return 0;
    }
    else if (cmd == CALI_FUNC_CMD_ON)
    {
//        if (cmd_cali_gimbal_hook(&local_cali_t->yaw_offset, &local_cali_t->pitch_offset,
//                                 &local_cali_t->yaw_max_angle, &local_cali_t->yaw_min_angle,
//                                 &local_cali_t->pitch_max_angle, &local_cali_t->pitch_min_angle))
//        {
            cali_buzzer_off();

            return 1;
//        }
//        else
        {
            gimbal_start_buzzer();

            return 0;
        }
    }

    return 0;
}
