ysp-021228/wheel-legged_robot/(commit log)

2023-10-16 Gyroscope adds Getter function
2023-10-16 Change the way the Chassis structure is declared
2023-10-16 Change the way the Chassis file enumeration body is declared
2023-10-16 Add getter to chassis
2023-10-17 The original PID-related code on the chassis was removed
2023-10-17 Change the Angle member in the chassis structure
2023-10-17 Changes the chassis mode enumeration body
2023-10-17 Change the chassis speed expectation variable
2023-10-17 Complete the forward kinematic structure
2023-10-17 Add the inverse kinematics structure
2023-10-17 Improve the chassis structure
2023-10-18 Change the chassis structure
2023-10-18 The positive kinematics solution is added
2023-10-18 Modify the chassis code slightly
2023-10-18 Add CyberGear driver
2023-10-19 Change the way Xiaomi motor structure is declared
2023-10-19 Test the use of CyberGear motors
2023-10-19 Add wheel motor structure
2023-10-19 Get two wheel motor data
2023-10-19 Add wheel odometer
2023-10-20 Adjust the chassis task main cycle
2023-10-20 Change the chassis Angle feedback unit
2023-10-20 Change the imu feedback structure
2023-10-24 Added CyberGear initialization and current sending functions
2023-10-25 add chassis_K_matrix_fitting
2023-10-26 Add gyroscope angular velocity acquisition
2023-10-27 add chassis_motors_torque_set_point_cal
2023-10-27 Wheel leg mode control process completed
2023-10-28 Complete motor initialization
2023-10-28 The phi solution is verified to be correct
    [Chassis.c, Chassis.h]
2023-10-28 The acceleration direction and kinematics are verified correctly
    [Chassis.c]
2023-10-28 Correct errors in polynomial fitting
    [Chassis.c]
2023-10-29 Fixed a problem with left and right leg orientation before the state variable gets function
    [Chassis.c, Chassis.h]
2023-10-29 leg_state_variable_reference_get verified to be correct
    [Chassis.c]
2023-10-29 leg_state_variable_error_get verified to be correct
    [Chassis.c]
2023-10-30 Solve the torque overflow problem
    [Chassis.c, Chassis.h]
2023-10-30 Add drive wheel control
2023-11-01 Basically confirmed the direction is correct, adjusting the parameters
    [Chassis.c]
2023-11-01 add L0 PID controller
2023-11-03 add vw pid
2023-11-07 Reposition your left leg in the direction
2023-11-10 The two legs fit the K-matrix separately
2023-11-13 The LQR parameter was readjusted
    It currently swings upright within half a meter
2023-11-14 Adjust the pid parameters of leg length
2023-11-14 Adjust the steering pid parameters
2023-11-15 add chassis_off_ground_detection
2023-11-15 Organize the chassis control code architecture
2023-11-15 Add remote control to control pitch Angle
2023-11-15 Organize the chassis header file
2023-11-16 Perfect off ground treatment
2023-11-16 Adjust roll pid parameters
2023-11-16 Adjust the off-ground processing logic
2023-11-16 Add steering Angle limiting
2023-11-17 Shock processing was added, but the test failed
    [Chassis.c, Chassis.h]
2023-12-11 Change how torque is calculated
2023-12-11 Fixed the chassis startup bug
    [Chassis.c]
2023-12-13 add CHASSIS_LEG_COORDINATION_PID
2023-12-16 Steering changed to absolute Angle control
2023-12-17 Added leg reset function
    [Chassis.c]
2023-12-17 Add wheel acceleration fetch
2023-12-18 Added led library
2023-12-19 add wheel.torque_reference
2023-12-22 Adjust leg length parameters
2023-12-24 Reduced falling standing torque
